kruan8/DataLogger/README.md

# DataLogger
STM32L031
The device can record ambient temperature to flash memory.
The user can configure and download data via serial line.
