kruan8/DataLogger/Documents/Schematic/dataLogger-TR.pdf

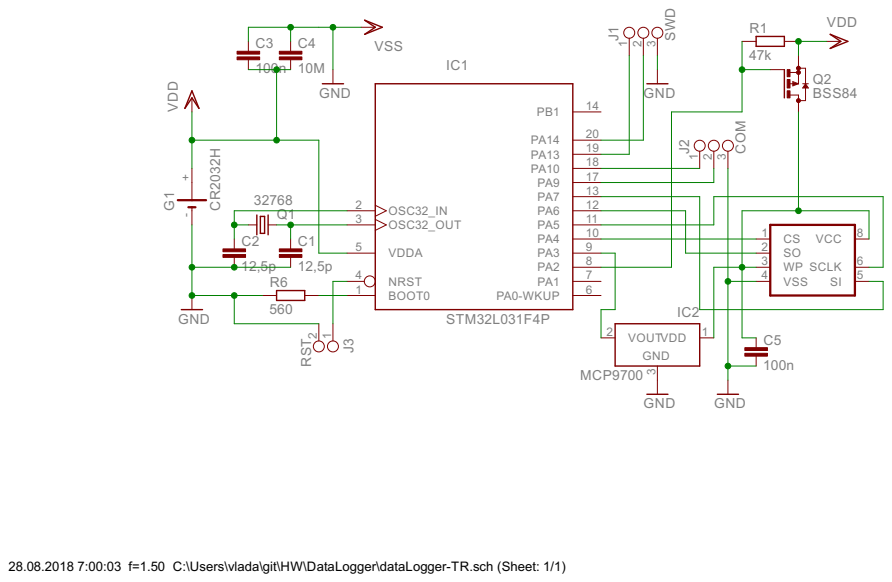
[picture p1: page 1]

28.08.2018 7:00:03 f=1.50 C:\Users\vlada\git\HW\DataLogger\dataLogger-TR.sch (Sheet: 1/1)
