kruan8/DataLogger/Documents/PCB/dataLogger-TR.brd

## EAGLE design Documents/PCB/dataLogger-TR.brd (2018-08-03, last stored version)

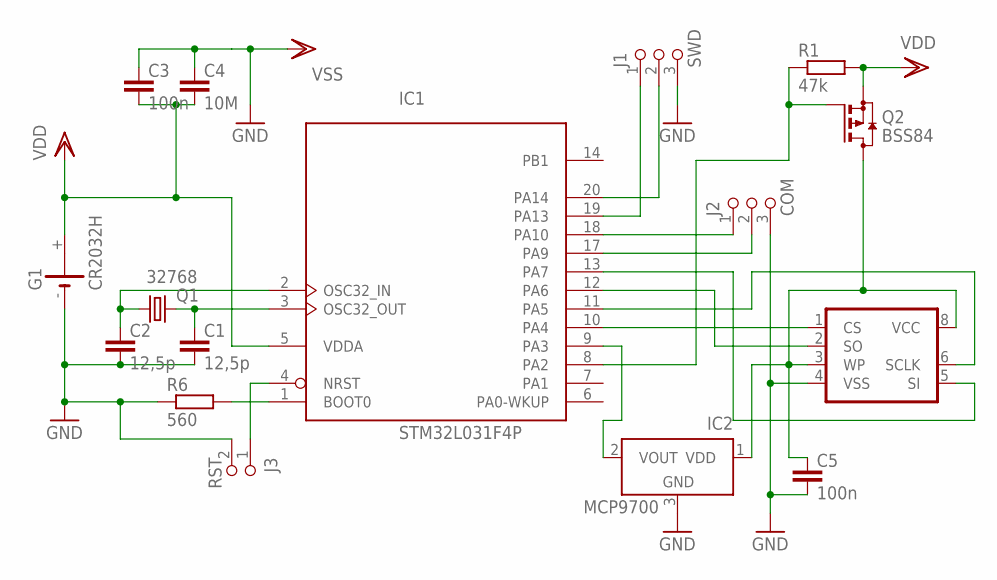
[picture p2: schematic dataLogger-TR.sch]

Parts:
C1, C2: 12,5p; 0805
C3, C5: 100n; 0805
C4: 10M; 0805
G1: CR2032H
IC1: STM32L031F4P; TSSOP20-I
IC2: MCP9700; SOT23
J1: SWD; HEAD1X3I
J2: COM; HEAD1X3I
J3: RST; HEAD1X2I
Q1: 32768; TC38H-SMD
Q2: BSS84; SOT23
R1: 47k; R0805
R6: 560; R0805
U$1: GD25; SO08

Connections:
GND: C1.2, C2.2, C3.1, C4.1, C5.2, G1.-, IC1.15 (VSS), IC2.3 (GND), J1.3, J2.3, J3.2, R6.1, U$1.4 (VSS)
unnamed: IC1.1 (BOOT0), R6.2
unnamed: IC1.4 (NRST), J3.1
unnamed: IC1.10 (PA4), U$1.1 (CS)
unnamed: IC1.20 (PA14), J1.2
unnamed: IC1.19 (PA13), J1.1
unnamed: IC1.18 (PA10), J2.1
unnamed: IC1.17 (PA9), J2.2
unnamed: IC1.8 (PA2), Q2.1 (G), R1.1
unnamed: IC1.11 (PA5), U$1.6 (SCLK)
unnamed: IC1.13 (PA7), U$1.5 (SI)
unnamed: IC1.12 (PA6), U$1.2 (SO)
unnamed: IC1.9 (PA3), IC2.2 (VOUT)
unnamed: C2.1, IC1.2 (OSC32_IN), Q1.P$1 (1)
unnamed: C1.1, IC1.3 (OSC32_OUT), Q1.P$2 (2)
unnamed: C5.1, IC2.1 (VDD), Q2.3 (D), U$1.3 (WP), U$1.8 (VCC)
VDD: C3.2, C4.2, G1.+, IC1.5 (VDDA), IC1.16 (VDD), Q2.2 (S), R1.2

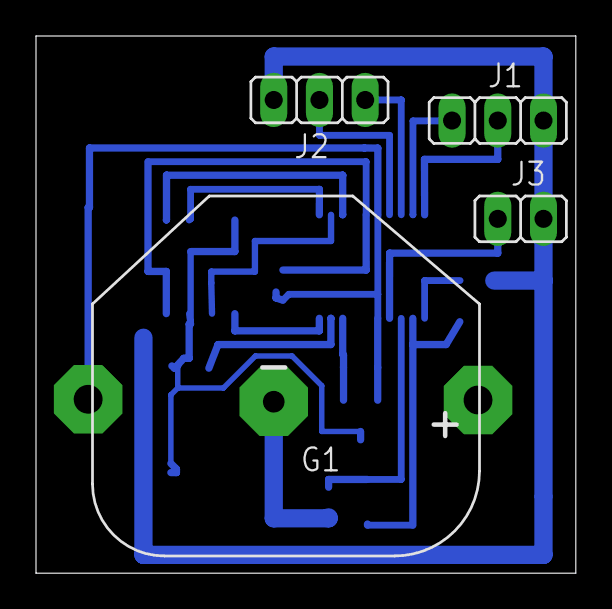
[picture p3: board dataLogger-TR.brd from above]

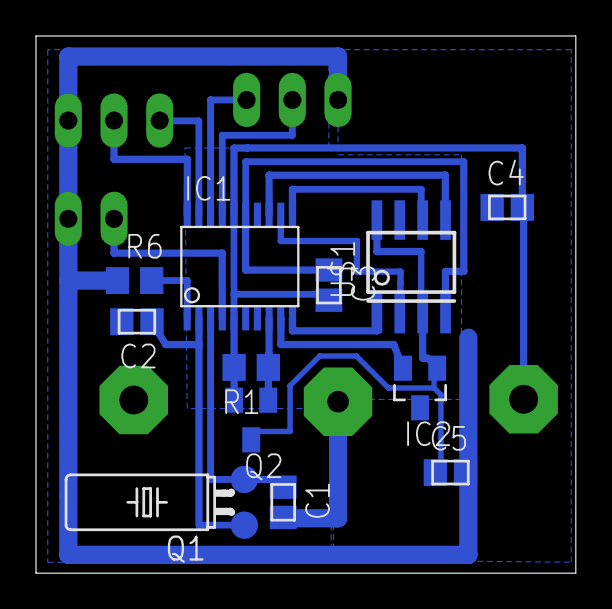
[picture p4: board dataLogger-TR.brd from below]

Board: 2 copper layers, 30.0 x 29.8 mm, 16 parts (12 on the bottom side), 17 nets.
