kruan8/DataLogger/src/usart.c

/*
 * usart.c
 *
 *  Created on: 2. 11. 2016
 *  Author: Priesol Vladimir
 */

#include "usart.h"
#include <stdbool.h>
//#include <stdio.h>
#include <stdlib.h>
#include <string.h>
#include "rtc.h"
#include "FlashG25.h"
#include "adc.h"

#include "printf.h"

#include "stm32l0xx_ll_bus.h"
#include "stm32l0xx_ll_gpio.h"

#define BUFFER_SIZE  128

static uint8_t g_BufferIn[BUFFER_SIZE];
static uint8_t g_BufferInPos;
static bool    g_bCommandReady;

static uint32_t g_nRecords;
static uint32_t g_nFreeRecords;
static uint32_t g_nBatVoltage;

static const uint8_t T_Version[] = "---- DATA LOGGER v0.7 ----";
static const uint8_t T_Email[] = "vpriesol@seznam.cz";
static const uint8_t T_NewLine[] = "\r\n";

void USART_Init(void)
{
  /* Enable the peripheral clock of GPIOA */
//  LL_IOP_GRP1_EnableClock(LL_IOP_GRP1_PERIPH_GPIOA);
  RCC->IOPENR |= RCC_IOPENR_GPIOAEN;

  /* GPIO configuration for USART2 signals */
  /* (1) Select AF mode (10) on PA9 and PA10 */
  /* (2) AF4 for USART2 signals */
//  LL_GPIO_SetPinMode(GPIOA, LL_GPIO_PIN_9, LL_GPIO_MODE_ALTERNATE);
//  LL_GPIO_SetPinMode(GPIOA, LL_GPIO_PIN_10, LL_GPIO_MODE_ALTERNATE);
//  LL_GPIO_SetAFPin_8_15(GPIOA, LL_GPIO_PIN_9, LL_GPIO_AF_4);
//  LL_GPIO_SetAFPin_8_15(GPIOA, LL_GPIO_PIN_10, LL_GPIO_AF_4);

  GPIOA->MODER = (GPIOA->MODER & ~(GPIO_MODER_MODE9|GPIO_MODER_MODE10)) | (GPIO_MODER_MODE9_1 | GPIO_MODER_MODE10_1); /* (1) */
  GPIOA->AFR[1] = (GPIOA->AFR[1] &~ (0x00000FF0))  | (4 << (1 * 4)) | (4 << (2 * 4)); /* (2) */

  /* Enable the peripheral clock USART2 */
  RCC->APB1ENR |= RCC_APB1ENR_USART2EN;

  // baudrate vypocitat ze SystemCoreClock
  USART2->BRR = (uint8_t)(SystemCoreClock / 57600);

  /* TX&RX enable, USART enable, 8 data bit, 1 start bit, 1 stop bit, no parity*/
  USART2->CR1 = USART_CR1_TE | USART_CR1_RE | USART_CR1_UE;

  /* polling idle frame Transmission */
  while((USART2->ISR & USART_ISR_TC) != USART_ISR_TC)
  {
    /* add time out here for a robust application */
  }

  g_bCommandReady = false;
  g_BufferInPos = 0;

  USART2->CR1 |= USART_CR1_RXNEIE;      // enable RX INT

  //  USART2->ICR = USART_ICR_TCCF;/* clear TC flag */
  //  USART2->CR1 |= USART_CR1_TCIE;/* enable TC interrupt */

  NVIC_SetPriority(USART2_IRQn, 1);
  NVIC_EnableIRQ(USART2_IRQn);
}

void USART_DeInit(void)
{
  USART2->CR1 = 0;      // enable RX INT
  NVIC_DisableIRQ(USART2_IRQn);
  RCC->APB1ENR &= ~RCC_APB1ENR_USART2EN;

  // Set GPIOs to analog mode
  GPIOA->MODER |= (GPIO_MODER_MODE9_1 | GPIO_MODER_MODE9_0 | GPIO_MODER_MODE10_1 | GPIO_MODER_MODE10_0);
}

bool USART_ProcessCommand()
{
  if (!g_bCommandReady)
  {
    return false;
  }

  strupr((char*)g_BufferIn);
  USART_PrintLine(g_BufferIn);
  switch (g_BufferIn[0])
  {
    case 0:
      USART_PrintHelp();
      break;
    case 'S':
      USART_PrintStatus();
      break;
    case 'L':
      APP_PrintRecords();
      break;
    case 'D':
      USART_SetDate();
      break;
    case 'T':
      USART_SetTime();
      break;
    case 'I':
      USART_SetInterval();
      break;
    case 'X':
      USART_EraseMemory();
      break;
    case 'C':
      USART_CalTemp();
      break;
    default:
      USART_PrintLine((uint8_t*)"???");
      break;
  }

  g_BufferInPos = 0;
  g_bCommandReady = false;
  USART2->CR1 |= USART_CR1_RXNEIE;
  USART_Putc('>');

  return true;
}

void USART_PrintHeader(uint32_t nRecords, uint32_t nFreeRecords, uint32_t nBatVoltage, app_error_t eErr)
{
  g_nRecords = nRecords;
  g_nFreeRecords = nFreeRecords;
  g_nBatVoltage = nBatVoltage;

  USART_PrintNewLine();
  USART_PrintLine(T_Version);
  USART_PrintLine(T_Email);

  USART_PrintNewLine();

  USART_PrintStatus();
  USART_PrintNewLine();

  switch (eErr)
  {
  case err_supply:
    USART_PrintLine((uint8_t*)"Supply voltage is LOW!");
    break;
  case err_init_flash_error:
    USART_PrintLine((uint8_t*)"Init memory ERROR!");
    break;
  case err_full_memory:
    USART_PrintLine((uint8_t*)"FULL MEMORY!");
    break;
  case err_write_flash_error:
    USART_PrintLine((uint8_t*)"Memory write ERRROR!");
    break;
  case err_ok:
      break;
  }
}

void USART_PrintStatus()
{
  uint8_t text[50];

  snprintf_((char*)text, sizeof (text), "Date&time: ");
  USART_Print(text);
  USART_PrintDateTime();
  uint16_t nVDDA = Adc_MeasureRefInt_mV();
  snprintf_((char*)text, sizeof (text), "Battery:%d,%.2d(V) '(>2,6V)'", nVDDA / 1000, (nVDDA / 10) % 100);
  USART_PrintLine(text);
  int16_t temp = Adc_CalcTemperature(Adc_CalcValueFromVDDA(Adc_MeasureTemperature(), nVDDA), true);
  USART_Print((uint8_t*)"Temperature:");
  USART_PrintTemperature(temp);
  USART_PrintLine((uint8_t*)"(C)");
  USART_PrintInterval();
  snprintf_((char*)text, sizeof (text), "Number of records:%lu", g_nRecords);
  USART_PrintLine(text);
  uint32_t nDays = g_nFreeRecords / (86400 / APP_GetInterval_s());
  snprintf_((char*)text, sizeof (text), "Free memory:%lu records (%lu days)", g_nFreeRecords, nDays);
  USART_PrintLine(text);
  USART_Print((uint8_t*)"Temperature calibration offset: ");
  USART_PrintTemperature(Adc_GetTempOffset());
  USART_PrintLine((uint8_t*)"(C)");
  USART_Print((uint8_t*)"Memory type: ");
  USART_PrintLine((uint8_t*)FlashG25_GetTypeString());
}

void USART_PrintHelp()
{
  USART_PrintLine((uint8_t*)"COMMANDS:");
  USART_PrintLine((uint8_t*)"Print status: 'S'");
  USART_PrintLine((uint8_t*)"Set date: 'D dd.mm.yy' (25.3.16)");
  USART_PrintLine((uint8_t*)"Set time: 'T hh:mm' (14:10)");
  USART_PrintLine((uint8_t*)"Set interval (min): 'I mm' (30)");
  USART_PrintLine((uint8_t*)"Temperature list: 'L'");
  USART_PrintLine((uint8_t*)"Erase memory: 'X+X'");
  USART_PrintLine((uint8_t*)"Erase internal error: 'X+E'");
  USART_PrintLine((uint8_t*)"Temperature calibration: 'CALxxx' (CAL225=22,5)");
  USART_PrintLine((uint8_t*)"Print help: ENTER");
}

void USART_PrintTemperature(int16_t nTemp)
{
  uint8_t text[50];
  if (nTemp < 0)
  {
    USART_Putc('-');
  }

  nTemp = abs (nTemp);
  snprintf_((char*)text, sizeof (text), "%d,%d", nTemp / 10, nTemp % 10);
  USART_Print(text);
}

void USART_EraseMemory()
{
  if (g_BufferIn[1] == '+' && g_BufferIn[2] == 'X')
  {
    // vymazat pamet
    for (uint8_t i = 0; i < FlashG25_GetSectors(); i++)
    {
      FlashG25_SectorErase(i);
      USART_Putc('x');
    }

    APP_LogError(err_ok);
    App_ClearBackup();

    USART_PrintNewLine();
    USART_PrintLine((uint8_t*)"Memory & error are erased, reset performed");

    USART_WaitForTC();
    NVIC_SystemReset();
  }
  else if (g_BufferIn[1] == '+' && g_BufferIn[2] == 'E')
  {
    APP_LogError(err_ok);
    App_ClearBackup();
    USART_PrintNewLine();
    USART_PrintLine((uint8_t*)"Internal error is erased, reset performed");

    USART_WaitForTC();
    NVIC_SystemReset();
  }
}

void USART_SetDate()
{
  rtc_record_time_t rtime;

  if (atoi((char*)&g_BufferIn[1]))  // pokud je první hodnota platné èíslo
  {
    const char s[2] = ".";
    char *pos = strtok((char*)&g_BufferIn[1], s); // find first occure
    rtime.day = atoi(pos);

    pos = strtok(NULL, s); // find first occure
    rtime.month = atoi(pos);

    pos = strtok(NULL, s);
    rtime.year = atoi(pos);

    RTC_Set(&rtime, true, false);
  }

  USART_PrintDateTime();
}

void USART_SetTime()
{
  rtc_record_time_t rtime;

  if (atoi((char*)&g_BufferIn[1]))  // pokud je první hodnota platné èíslo
  {
    const char s[2] = ":";
    char *pos = strtok((char*)&g_BufferIn[1], s); // find first occure
    rtime.hour = atoi(pos);

    pos = strtok(NULL, s);  // find first occure
    rtime.min = atoi(pos);

    pos = strtok(NULL, s);
    rtime.sec = atoi(pos);

    RTC_Set(&rtime, false, true);
  }

  USART_PrintDateTime();
}

void USART_SetInterval()
{
  if (g_BufferIn[1])
  {
    uint16_t nInterval = atoi((char*)&g_BufferIn[1]);
    if (nInterval)
    {
      APP_SaveInterval(nInterval * 60);
    }
  }

  USART_PrintInterval();
}

void USART_PrintInterval()
{
  uint8_t text[25];
  snprintf_((char*)text, sizeof(text), "Interval=%d min", (uint16_t)(APP_GetInterval_s() / 60));
  USART_PrintLine(text);
}

void USART_PrintDateTime()
{
  uint8_t text[20];
  RTC_PrintDT(text, sizeof(text));
  USART_PrintLine(text);
}

void USART_CalTemp()
{
  // hodnota se zadava v desetinnach stupne (CAL225 = kalibrace na 22,5 C)
  if (!strncmp((char*)g_BufferIn, "CAL", 3))
  {
    if (g_BufferIn[3])
    {
      int16_t nCalTemp = atoi((char*)&g_BufferIn[3]);
      if (nCalTemp)
      {
        // zmerit teplotu a ulozit rozdil teplot (ofset)
        int16_t temp = Adc_GetTemperature(false);
        APP_SaveTempOffset(nCalTemp - temp);  // odecist -> offset budeme pri vypoctu teploty pricitat
      }
    }
  }
}

void USART_Putc(uint8_t ch)
{
  while (!(USART2->ISR & USART_ISR_TXE));
  USART2->TDR = ch;
}

void USART_Print(const uint8_t* text)
{
  while (*text)
  {
    USART_Putc(*text++);
  }
}

void USART_PrintLine(const uint8_t* text)
{
  USART_Print(text);
  USART_Print(T_NewLine);
}

void USART_PrintNewLine()
{
  USART_Print(T_NewLine);
}

void USART_WaitForTC()
{
  while (!(USART2->ISR & USART_ISR_TC));
}

void USART2_IRQHandler(void)
{
  if (g_bCommandReady)
  {
    return;
  }

  if (USART2->ISR & USART_ISR_RXNE)
  {
    g_BufferIn[g_BufferInPos] = USART2->RDR;

    // End of line!
    if (g_BufferIn[g_BufferInPos] == '\r')
    {
      g_BufferIn[g_BufferInPos] = 0;
      USART2->CR1 &= ~USART_CR1_RXNEIE;     // disable RX INT
      g_bCommandReady = true;
    }

    if (g_BufferInPos < (BUFFER_SIZE - 1))
    {
      g_BufferInPos++;
    }
  }
}
