kruan8/DataLogger/(commit log)

2017-01-24 verze pro novou PCB (tranzistor)
2018-07-26 index on PCB_with_BSS84: c3ccf79 oprava nastavení verze C (strupr funkce), doplnena chybova hlaska
2018-08-03 kontrola velikosti napajeciho napeti, vymaz chyby pri mazani pameti
    [dataLogger-TR.brd, dataLogger-TR.sch]
2018-08-31 rozbehany mod standby
    [dataLogger-TR.sch]
2019-12-03 added parameter for erasing internal error, log error update
    [App.c, usart.c]
